michalstocki/tiny-timer/docs/obudowa-klin-4/renders/16-przekroj-przycisk-plus.png

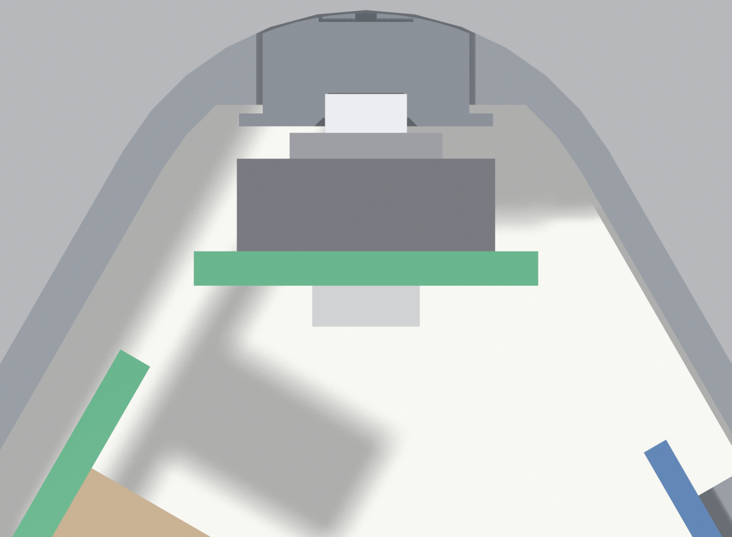
docs/obudowa-klin-4/renders/16-przekroj-przycisk-plus.png
