michalstocki/tiny-timer/docs/obudowa-klin-4/renders/10-ogniwa-od-gory.png

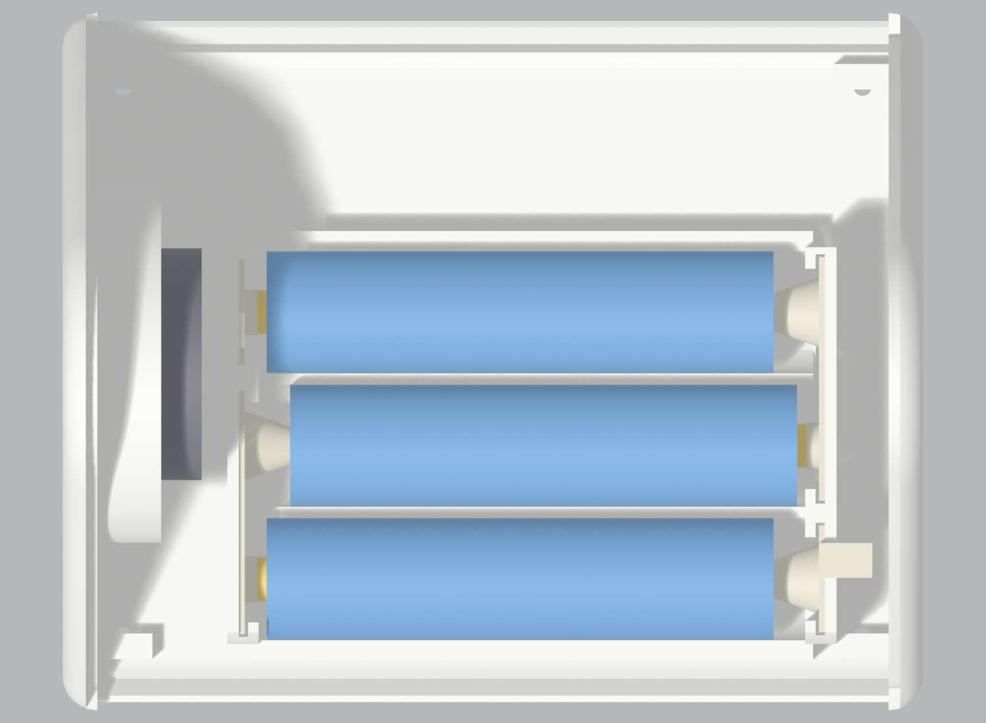
docs/obudowa-klin-4/renders/10-ogniwa-od-gory.png
