michalstocki/tiny-timer/docs/obudowa-klin-4/renders/01-przod-iso.png

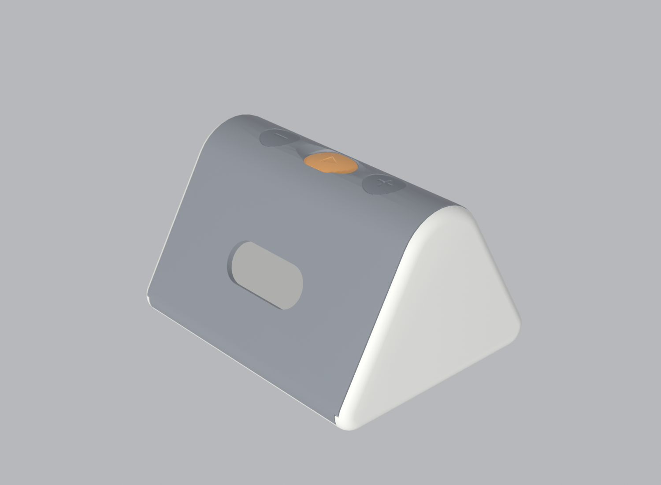
docs/obudowa-klin-4/renders/01-przod-iso.png
