michalstocki/tiny-timer/docs/obudowa-klin-4/renders/02-przod-prostopadle.png

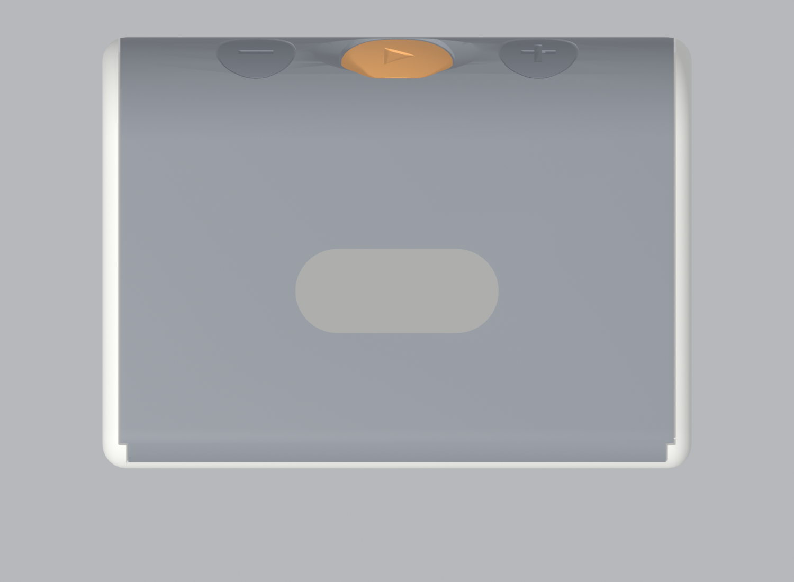
docs/obudowa-klin-4/renders/02-przod-prostopadle.png
