michalstocki/tiny-timer/docs/obudowa-klin-4/renders/03-gora.png

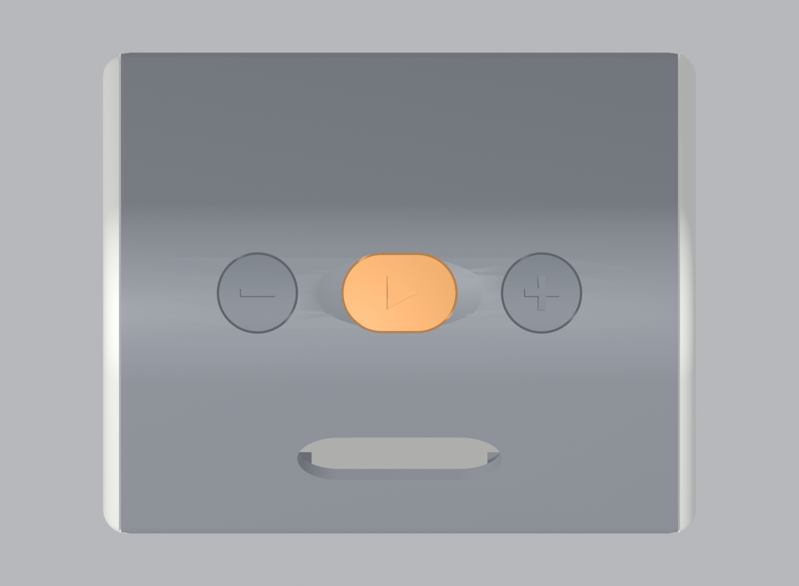
docs/obudowa-klin-4/renders/03-gora.png
