michalstocki/tiny-timer/docs/obudowa-klin-4/renders/04-bok-lewy-glosnik.png

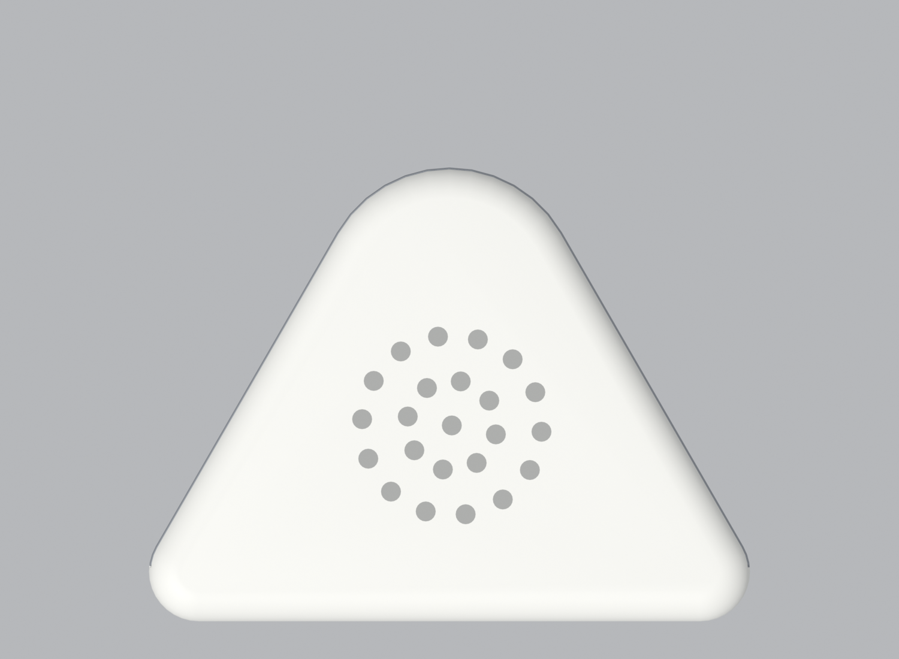
docs/obudowa-klin-4/renders/04-bok-lewy-glosnik.png
