michalstocki/tiny-timer/docs/obudowa-klin-4/renders/05-bok-prawy.png

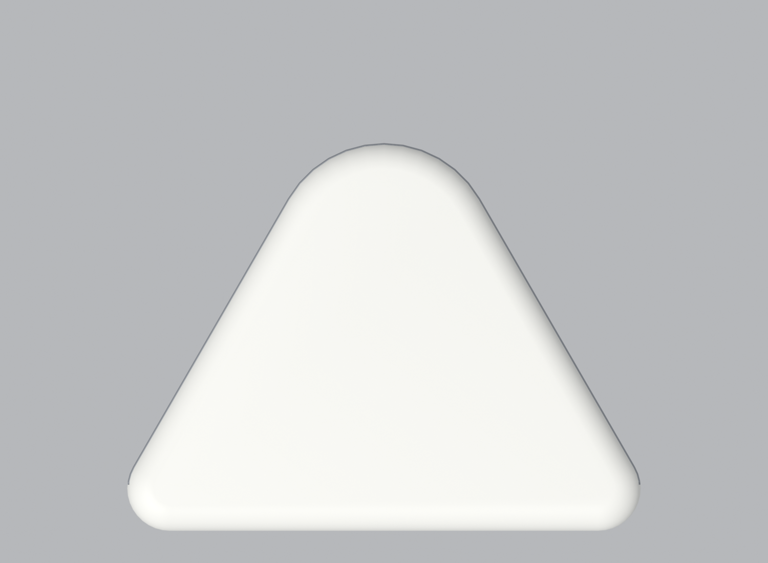
docs/obudowa-klin-4/renders/05-bok-prawy.png
