michalstocki/tiny-timer/docs/obudowa-klin-4/renders/06-spod.png

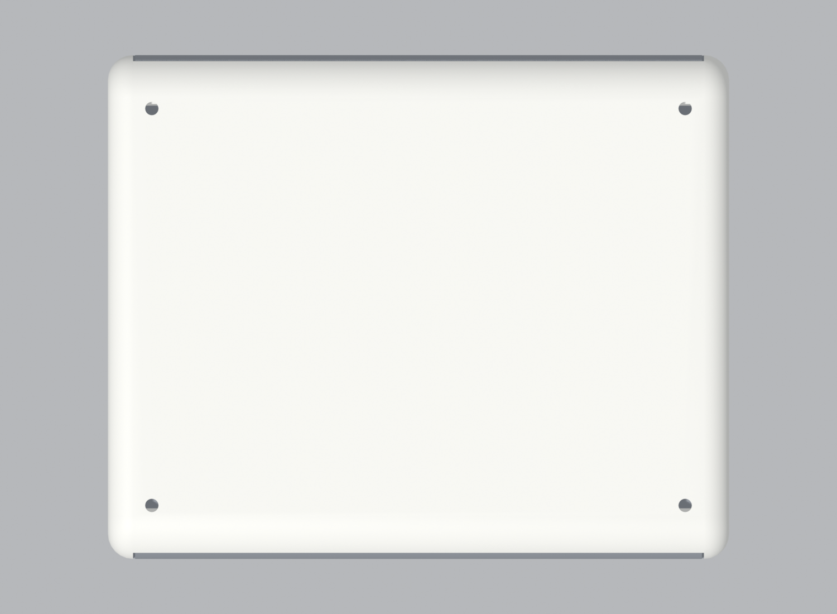
docs/obudowa-klin-4/renders/06-spod.png
