michalstocki/tiny-timer/docs/obudowa-klin-4/renders/07-tyl-iso.png

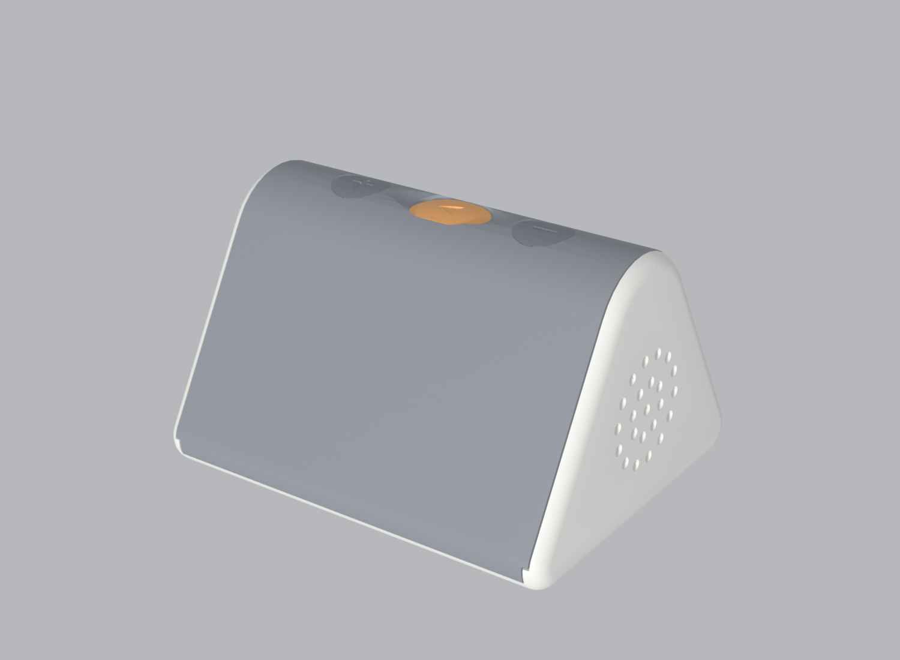
docs/obudowa-klin-4/renders/07-tyl-iso.png
