michalstocki/tiny-timer/docs/obudowa-klin-4/renders/08-tyl-prostopadle.png

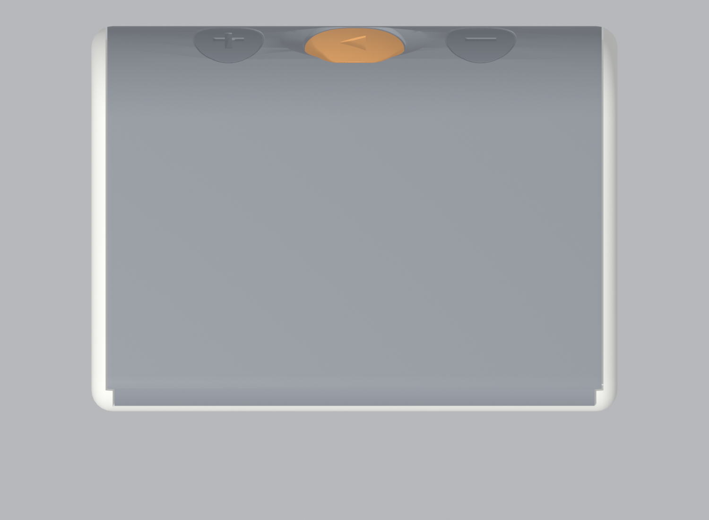
docs/obudowa-klin-4/renders/08-tyl-prostopadle.png
