michalstocki/tiny-timer/docs/obudowa-klin-4/renders/09-pokrywa-zdjeta.png

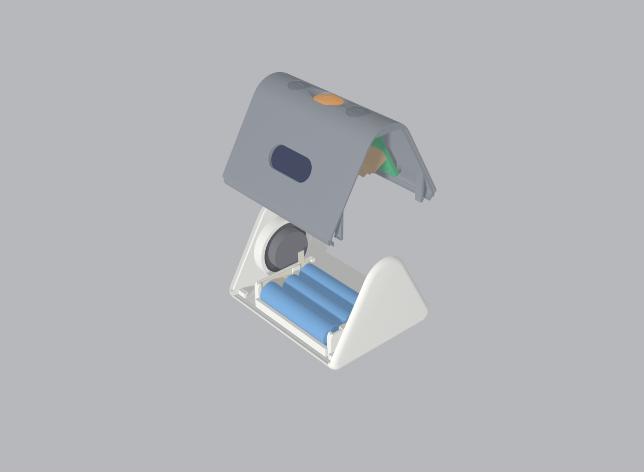
docs/obudowa-klin-4/renders/09-pokrywa-zdjeta.png
