michalstocki/tiny-timer/docs/obudowa-klin-4/renders/11-koszyk-styki.png

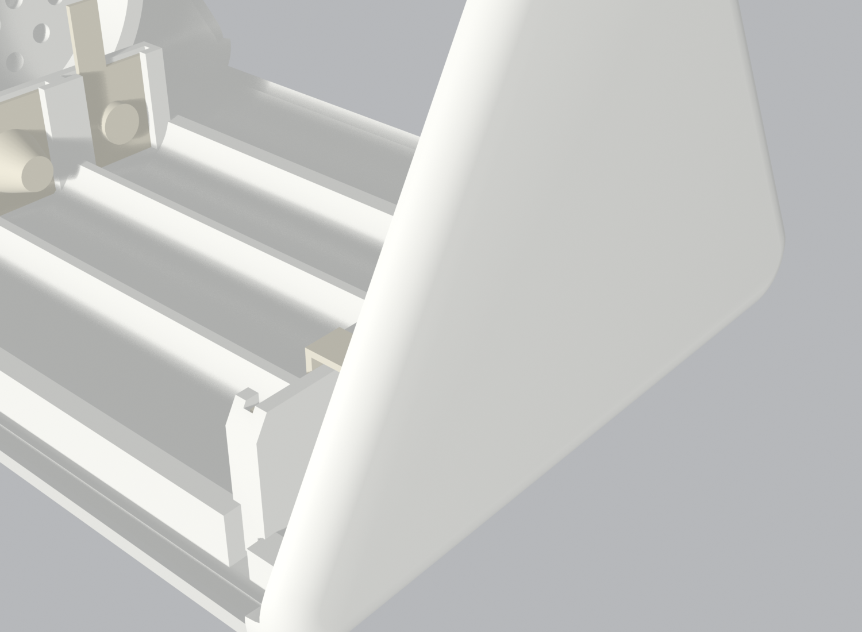
docs/obudowa-klin-4/renders/11-koszyk-styki.png
