michalstocki/tiny-timer/docs/obudowa-klin-4/renders/12-pokrywa-od-srodka.png

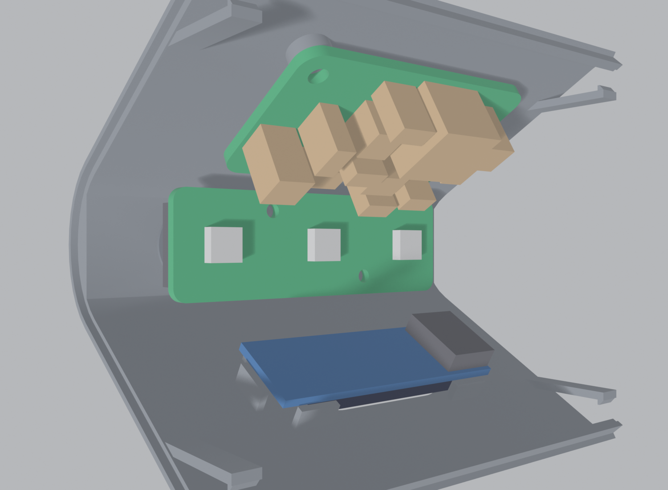
docs/obudowa-klin-4/renders/12-pokrywa-od-srodka.png
