michalstocki/tiny-timer/docs/obudowa-klin-4/renders/13-przekroj-poprzeczny.png

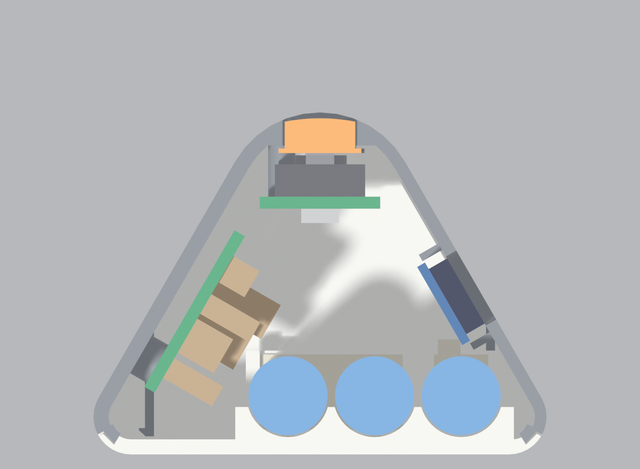
docs/obudowa-klin-4/renders/13-przekroj-poprzeczny.png
