michalstocki/tiny-timer/docs/obudowa-klin-4/renders/14-przekroj-zatrzaski.png

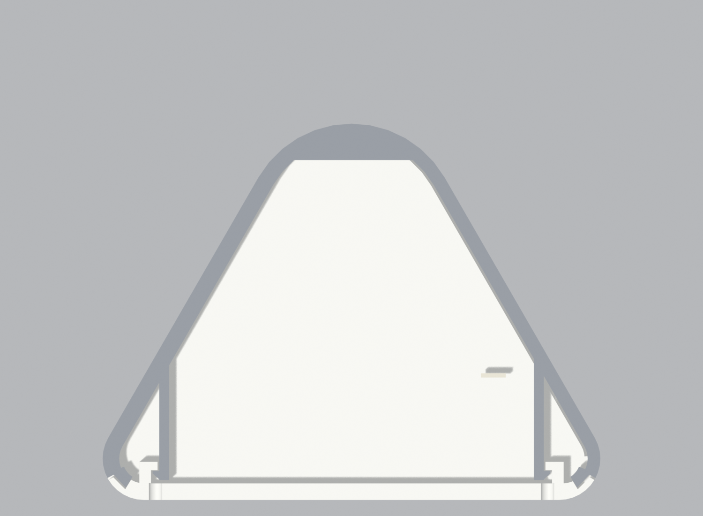
docs/obudowa-klin-4/renders/14-przekroj-zatrzaski.png
