michalstocki/tiny-timer/docs/obudowa-klin-4/renders/15-zatrzask-front-zblizenie.png

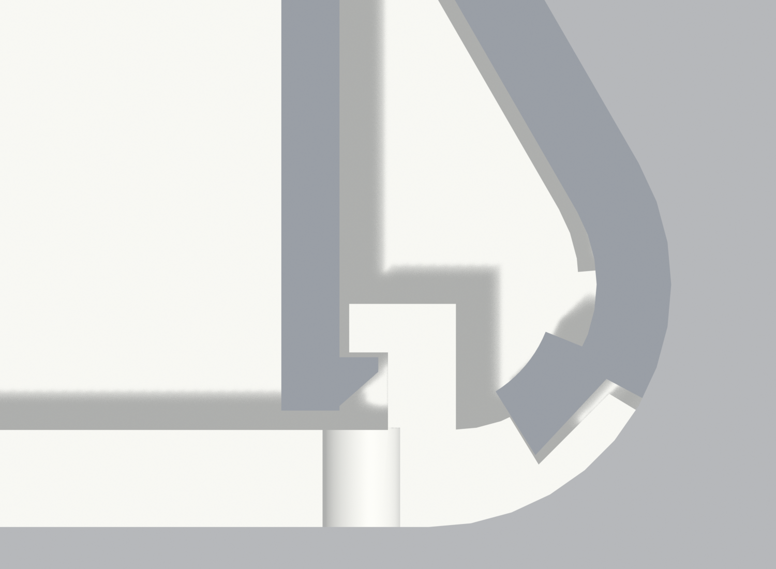
docs/obudowa-klin-4/renders/15-zatrzask-front-zblizenie.png
