michalstocki/tiny-timer/docs/obudowa-klin-4/renders/17-przyciski-zblizenie.png

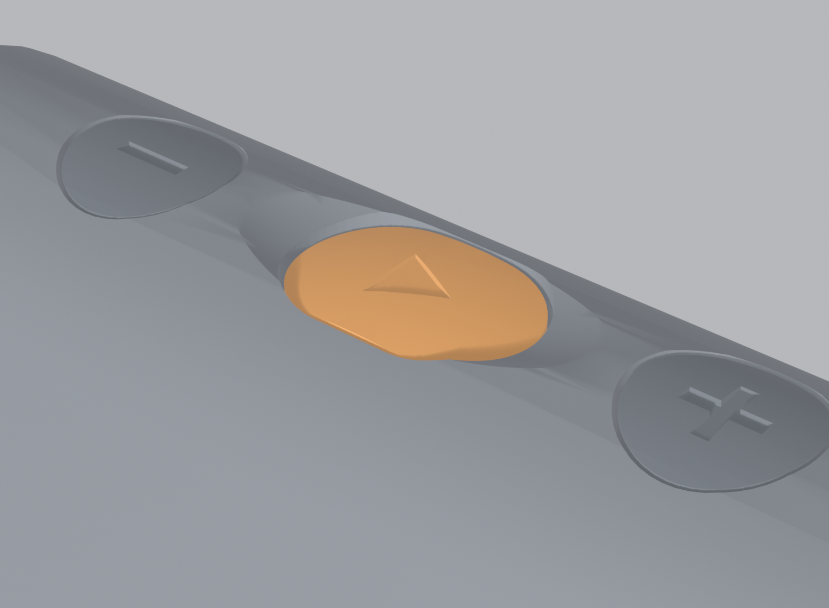
docs/obudowa-klin-4/renders/17-przyciski-zblizenie.png
