michalstocki/tiny-timer/docs/obudowa-klin-4/renders/18-kapsel-gniazdo.png

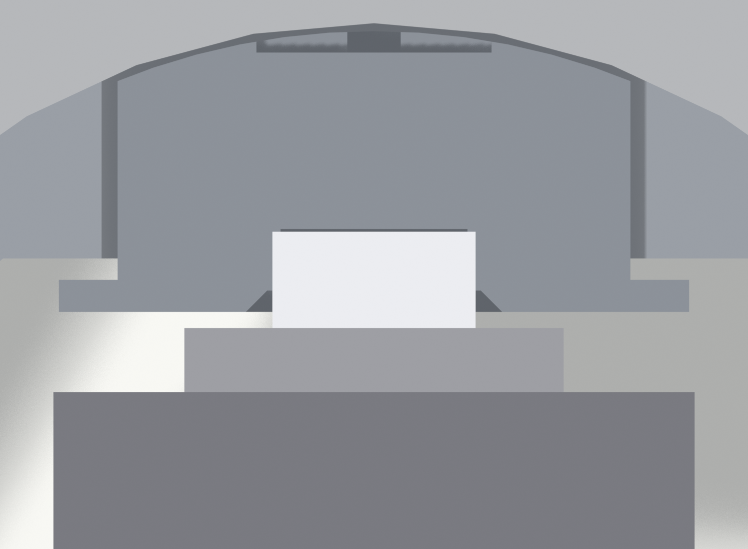
docs/obudowa-klin-4/renders/18-kapsel-gniazdo.png
