michalstocki/tiny-timer/docs/obudowa-klin-4/renders/19-przekroj-gniazda-styku.png

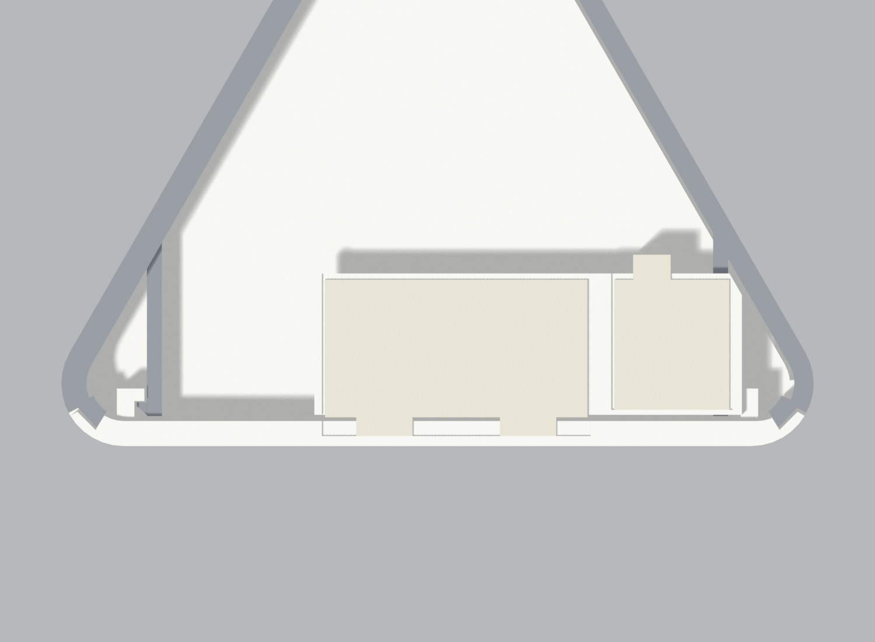
docs/obudowa-klin-4/renders/19-przekroj-gniazda-styku.png
