michalstocki/tiny-timer/docs/obudowa-klin-4/renders/20-szew-tylu-zblizenie.png

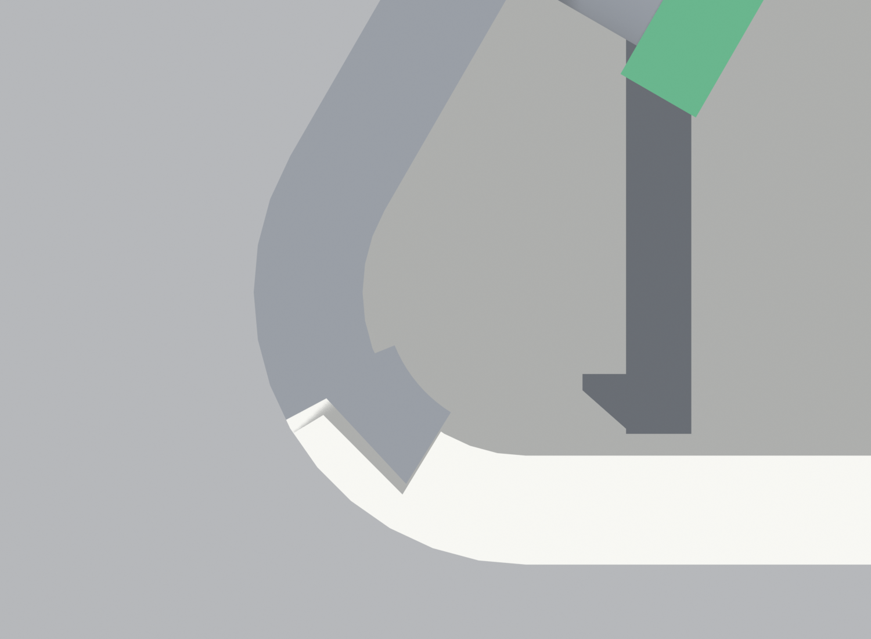
docs/obudowa-klin-4/renders/20-szew-tylu-zblizenie.png
