michalstocki/tiny-timer/docs/obudowa-klin-4/pokrywa.stl

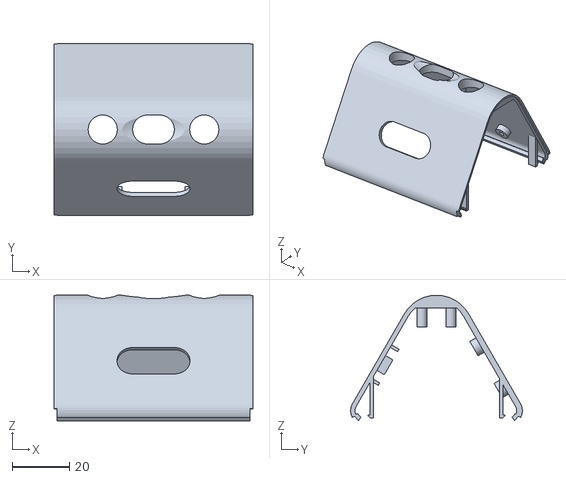
[picture p23: CAD file, 2026-10-22]
docs/obudowa-klin-4/pokrywa.stl
69.7 x 60.2 x 44.0
