michalstocki/tiny-timer/docs/obudowa-klin-4/korpus.stl

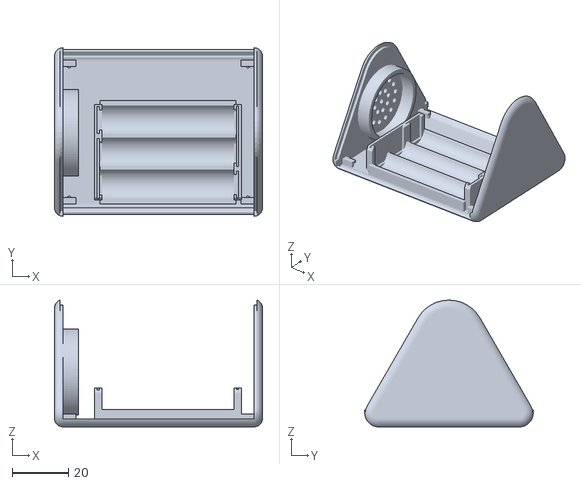
[picture p24: CAD file, 2026-10-22]
docs/obudowa-klin-4/korpus.stl
74.2 x 60.2 x 45.3
