michalstocki/tiny-timer/docs/obudowa-klin-4/kapsle.stl

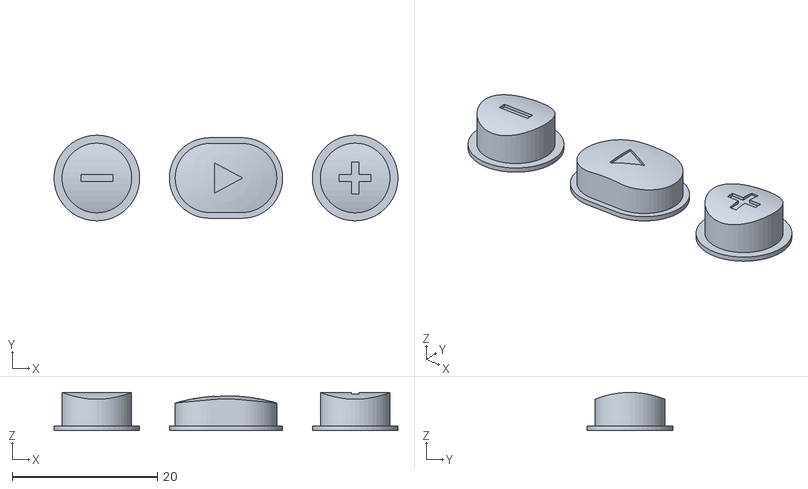
[picture p25: CAD file, 2026-10-22]
docs/obudowa-klin-4/kapsle.stl
47.4 x 11.8 x 5.25
