michalstocki/tiny-timer/(list of files, cad)

Other CAD files:
docs/obudowa-klin-4/obudowa-klin-4-bez-zaczepow.blend
docs/obudowa-klin-4/obudowa-klin-4.blend
