michalstocki/tiny-timer/(list of files, drawings)

Other design files:
docs/pcb-klin3/pcb-layout.json
