michalstocki/tiny-timer/docs/plytka-glowna/tt-main.kicad_pcb

## KiCad design docs/plytka-glowna/tt-main.kicad_pcb (2026-10-22)

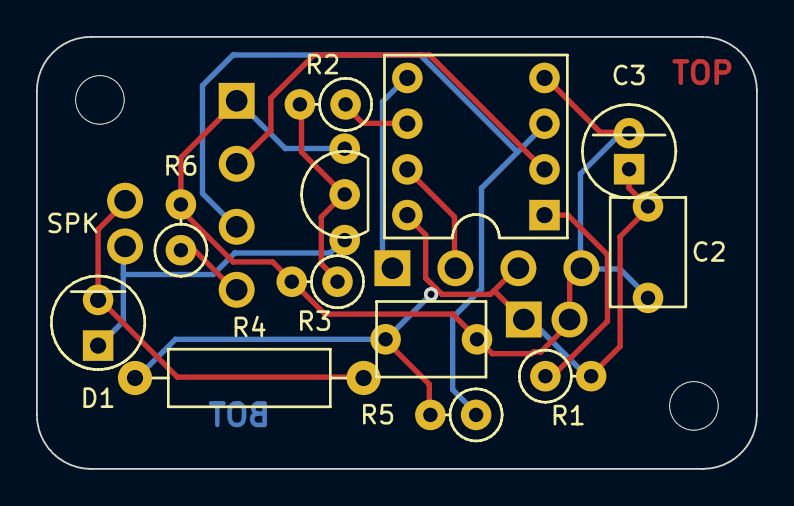
[picture p26: board tt-main.kicad_pcb from above]

Board: 2 copper layers, 40.0 x 24.0 mm, 18 parts (0 on the bottom side), 12 nets.

Parts:
BAT: battery leads; wire2
C1, C2: 100 nF; cap5
C3: 100 uF; elco5
D1: LED; led
DISP: display module leads; wire4
KEY: button board leads; wire4
MH1, MH2: M2.5; MountingHole_M2.5
Q1: BC547B; to92
R1: 15 k; res_v
R2: 470; res_v
R3: 47 k; res_v
R4: 33, 1/2 W; res_h
R5, R6: 8.2 k; res_v
SPK: speaker leads; wire2
U1: ATtiny13A in DIP-8 socket; dip8

Connections:
BASE: Q1.B, R2.2, R3.1
COLL: D1.A, Q1.C, SPK.2
GND: BAT.2, C1.1, C2.1, C3.-, DISP.4, KEY.1, Q1.E, R3.2, R6.2, U1.4
PB1: R2.1, U1.6
PB3: KEY.2, U1.2
PB4: KEY.3, R5.1, U1.3
RESET: R1.1, U1.1
S3LOW: KEY.4, R6.1
SCL: DISP.2, U1.7
SDA: DISP.1, U1.5
SPKR: D1.K, R4.1, SPK.1
VCC: BAT.1, C1.2, C2.2, C3.+, DISP.3, R1.2, R4.2, R5.2, U1.8
