michalstocki/tiny-timer/firmware/src/render.c

/* Frame renderer: "M:SS" (5x7 font scaled x3), 1 px progress frame, bell.
 * Pure computation, no hardware access: also built on the host
 * (tools/host_render.c) to check the picture without a display.
 *
 * The OLED is in VERTICAL addressing mode, so the stream is column by
 * column: 4 bytes (pages 0..3 = rows 0..31, bit0 = top) for x = 0..127. */
#include "oled.h"

#ifdef __AVR__
#include <avr/pgmspace.h>
#else
#define PROGMEM
#define pgm_read_byte(a) (*(const uint8_t *)(a))
#define pgm_read_word(a) (*(const uint16_t *)(a))
#endif

#define BELL_X 106 /* left column of the 16x16 bell, rows 8..23 */

NOINIT uint8_t txt[5];
#if FEATURE_BAR
NOINIT uint16_t bar_lit;
#endif
#if FEATURE_BELL
NOINIT uint8_t bell;
#endif

/* 5x7 font, glyph = 5 columns, bit0 = top row. 0-9 and ':'. */
static const uint8_t font[11 * 5] PROGMEM = {
    0x3E, 0x51, 0x49, 0x45, 0x3E, /* 0 */
    0x00, 0x42, 0x7F, 0x40, 0x00, /* 1 */
    0x42, 0x61, 0x51, 0x49, 0x46, /* 2 */
    0x21, 0x41, 0x45, 0x4B, 0x31, /* 3 */
    0x18, 0x14, 0x12, 0x7F, 0x10, /* 4 */
    0x27, 0x45, 0x45, 0x45, 0x39, /* 5 */
    0x3C, 0x4A, 0x49, 0x49, 0x30, /* 6 */
    0x01, 0x71, 0x09, 0x05, 0x03, /* 7 */
    0x36, 0x49, 0x49, 0x49, 0x36, /* 8 */
    0x06, 0x49, 0x49, 0x29, 0x1E, /* 9 */
    0x00, 0x00, 0x14, 0x00, 0x00, /* : */
};

#if FEATURE_BELL
/* 16x16 bell, one word per column (generated by tools/gen_bell.py). */
static const uint16_t bell_bmp[16] PROGMEM = {
    0x2000, 0x3800, 0x3E00, 0x3FC0, 0x3FF8, 0x7FFC, 0xFFFE, 0xFFFF,
    0xFFFF, 0xFFFE, 0x7FFC, 0x3FF8, 0x3FC0, 0x3E00, 0x3800, 0x2000,
};
#endif

NOINIT static uint8_t x; /* column being produced */

/* Emit one screen column. f = 7 font rows (bit0 = top). Every font row
 * becomes 3 screen rows: font row k -> rows 5+3k .. 7+3k (text is 21 px
 * tall in rows 5..25). */
static void col(uint8_t f)
{
    uint32_t v = 0;
    uint32_t m = 7UL << 5;

    for (uint8_t i = 7; i; i--) {
        if (f & 1)
            v |= m;
        f >>= 1;
        m <<= 3;
    }
#if FEATURE_BELL
    if (bell && (uint8_t)(x - BELL_X) < 16)
        v |= (uint32_t)pgm_read_word(&bell_bmp[x - BELL_X]) << 8;
#endif
#if FEATURE_BAR
    /* Frame pixels are numbered clockwise from the top-left corner:
     *   top row y=0:      idx = x                  (0..127)
     *   right col x=127:  idx = 127 + y            (y 1..31)
     *   bottom row y=31:  idx = 285 - x            (x 126..0)
     *   left col x=0:     idx = 316 - y            (y 30..1)
     * A pixel is lit when idx >= 316 - bar_lit, so the frame is erased
     * clockwise starting at the top-left corner. */
    int16_t start = BAR_PIXELS - bar_lit;
    if (x >= start)
        v |= 1UL;
    if (285 - x >= start)
        v |= 1UL << 31;
    if (x == 127 || x == 0) {
        for (uint8_t y = 1; y < 31; y++)
            if ((x ? 127 + y : 316 - y) >= start)
                v |= 1UL << y;
    }
#endif
    oled_put(v);
    oled_put(v >> 8);
    oled_put(v >> 16);
    oled_put(v >> 24);
    x++;
}

/* txt[] = {m10, m1, ':', s10, s1}; a zero in txt[0] is not drawn and the
 * remaining 4 cells (18 px each) are centered. */
void render_frame(void)
{
    uint8_t ci = !txt[0];            /* first cell drawn                   */

    x = 0;
    while (x < (ci ? 28 : 19))
        col(0);
    for (; ci < 5; ci++) {
        for (uint8_t fc = 0; fc < 6; fc++) {
            uint8_t f = 0, g = txt[ci]; /* 6th column is the gap           */
            if (fc < 5)
                f = pgm_read_byte(&font[(g << 2) + g + fc]);
            col(f);
            col(f);
            col(f);
        }
    }
    while (x < 128)
        col(0);
}
