michalstocki/tiny-timer/tools/pcb/export.py

#!/usr/bin/env python3
"""Exports for the enclosure agent: pcb-layout.json, pcb_params.scad,
side-view SVG and an interactive 3D preview (podglad-3d.html)."""
import json
import math
import os

import board as B


def layout_json():
    d = B.to_json()
    d["derived"] = dict(
        board_center=[B.D["cx"], B.D["cy"]],
        oled_module=dict(rect=B.body_rect("OLED"), pcb_thickness_assumed=1.2,
                         total_thickness_above_board=B.P["oled_thickness"] + B.P["oled_standoff"],
                         glass_rect=[B.D["oled_pin_x"] + B.P["glass_to_pin"],
                                     B.D["oled_cy"] - B.P["glass_h"] / 2,
                                     B.D["oled_pin_x"] + B.P["glass_to_pin"] + B.P["glass_w"],
                                     B.D["oled_cy"] + B.P["glass_h"] / 2]),
        buttons={ref: dict(centre=[B.PARTS[ref]["x"], B.PARTS[ref]["y"]], body=12.0,
                           plunger_square=B.P["btn_plunger"], cap_diameter=B.P["btn_cap_d"],
                           top_above_board=B.P["btn_height"],
                           label={"S3": "minus", "S1": "run", "S2": "plus"}[ref])
                 for ref in ("S3", "S1", "S2") if ref in B.PARTS},
        back_envelope_height=B.P["bottom_height"],
        front_free_zone_above_board="everything on the front except the OLED module and the buttons must stay below 2.0 mm (solder joints of the back parts)")
    if B.VARIANT == "klin":
        d["variant"] = "klin"
        d["derived"]["front_free_zone_above_board"] = "everything on the front except the OLED module must stay below 2.0 mm (solder joints of the back parts)"
        d["button_board"] = dict(
            note="separate board with the 3 buttons, wired to the KEY pads of the main board",
            width=52.0, depth=16.0, thickness=B.P["thickness"], corner_radius=2.0,
            buttons=[dict(label="minus", ref="S3", x=8.0, y=8.0), dict(label="run", ref="S1", x=26.0, y=8.0),
                     dict(label="plus", ref="S2", x=44.0, y=8.0)],
            mounting_holes=[dict(x=16.0, y=8.0, diameter=2.2), dict(x=36.0, y=8.0, diameter=2.2)],
            wires=dict(KEY1="GND (S1, S2 common)", KEY2="PB3 (S1 run)", KEY3="PB4 (S2 plus, S3 minus)",
                       KEY4="S3 low side (to R6 on the main board)"))
    return d


def layout_json_k3():
    """klin3: the main board carries only the electronics; display module and button board are separate (wired)."""
    d = B.to_json()
    d["variant"] = "klin3"
    d["derived"] = dict(
        board_center=[B.D["cx"], B.D["cy"]], back_envelope_height=B.P["bottom_height"],
        note="the board is mounted component side INWARDS on the rear wall of the enclosure; the TOP side (solder joints, "
             "trimmed leads up to 2.0 mm) faces the wall")
    d["display_module"] = dict(
        note="SSD1306 128x32 0.91\" module glued to the inside of the front panel, wired to the pads DISP 1..4",
        outline=[B.P["oled_len"], B.P["oled_h"]], thickness=B.P["oled_thickness"], glass=[B.P["glass_w"], B.P["glass_h"]],
        pin_to_end=B.P["oled_pin_to_edge"], glass_to_pin=B.P["glass_to_pin"], header_standoff=B.P["oled_standoff"],
        pins=["SDA", "SCL", "VCC", "GND"], wires=dict(DISP1="SDA", DISP2="SCL", DISP3="VCC", DISP4="GND"))
    # buttons 7 grid steps apart (17.78 mm) so the board can be a 2.54 mm perfboard; B3F legs (12.5 x 5.0) sit in a
    # 5 x 2 grid rectangle, so button centres are at half a grid step in x and the M2 holes midway between them land on
    # grid points; the holes are 2 grid steps off the button row (diagonally), so the enclosure posts clear the run cap flange
    pitch, g = 7 * 2.54, 2.54
    d["button_board"] = dict(
        note="separate board with the 3 buttons, wired to the KEY pads of the main board; fits a 2.54 mm perfboard",
        width=50.0, depth=16.0, thickness=B.P["thickness"], corner_radius=2.0, grid=2.54,
        buttons=[dict(label="minus", ref="S3", x=round(25.0 - pitch, 2), y=8.0), dict(label="run", ref="S1", x=25.0, y=8.0),
                 dict(label="plus", ref="S2", x=round(25.0 + pitch, 2), y=8.0)],
        mounting_holes=[dict(x=round(25.0 - pitch / 2, 2), y=round(8.0 - 2 * g, 2), diameter=2.2),
                        dict(x=round(25.0 + pitch / 2, 2), y=round(8.0 + 2 * g, 2), diameter=2.2)],
        wires=dict(KEY1="GND (S1, S2 common)", KEY2="PB3 (S1 run)", KEY3="PB4 (S2 plus, S3 minus)",
                   KEY4="S3 low side (to R6 on the main board)"))
    return d


def scad_params(d):
    L = ["// Generated by tools/pcb (iteration 1). Millimetres, front view, origin = lower-left of the board.",
         "board_w = %.2f; board_h = %.2f; board_t = %.2f; board_corner_r = %.2f;" % (
             d["board"]["width"], d["board"]["height"], d["board"]["thickness"], d["board"]["corner_radius"]),
         "mount_holes = [%s]; // [x, y]" % ", ".join("[%.2f, %.2f]" % (h["x"], h["y"]) for h in d["mounting_holes"]),
         "mount_hole_d = %.2f; mount_keepout_r = %.2f;" % (B.P["mount_d"], B.P["mount_keepout_r"])]
    o = d["derived"]["oled_module"]
    g = o["glass_rect"]
    L += ["oled_module = [%.2f, %.2f, %.2f, %.2f]; // x0, y0, x1, y1 (ESTIMATED module outline)" % tuple(o["rect"]),
          "oled_glass = [%.2f, %.2f, %.2f, %.2f];" % tuple(g),
          "oled_total_height = %.2f; // above the board's top surface (assumes 2.5 mm header standoff)" % o["total_thickness_above_board"]]
    for ref, b in d["derived"]["buttons"].items():
        L.append("button_%s = [%.2f, %.2f]; // centre; body 12x12, plunger 3.8 sq, cap d 7.1, top at %.1f mm" % (
            b["label"], b["centre"][0], b["centre"][1], b["top_above_board"]))
    if B.VARIANT == "base":
        L.append("button_top_height = %.2f; button_body = 12; button_plunger = 3.8; button_cap_d = 7.1;" % B.P["btn_height"])
    else:
        L.append("// buttons are on a separate board (48 x 16 mm), see pcb-layout.json: button_board")
    L.append("back_envelope_height = %.2f;" % B.P["bottom_height"])
    L.append("// back-side parts: [name, x0, y0, x1, y1, height]")
    items = []
    for ref, p in d["parts"].items():
        if p["side"] == "bottom" and p["body"]:
            b = p["body"]
            items.append('["%s", %.2f, %.2f, %.2f, %.2f, %.2f]' % (ref, b[0], b[1], b[2], b[3], p["height_above_board"]))
    L.append("back_parts = [\n  " + ",\n  ".join(items) + "\n];")
    return "\n".join(L) + "\n"


def side_svg():
    """Side elevation (looking along +x ... shows heights stack at the section through the middle button)."""
    S = 20.0
    M = 40
    W, H = B.P["W"], B.P["H"]
    t = B.P["thickness"]
    top_h = max(B.P["btn_height"] if B.VARIANT == "base" else 0.0, B.P["oled_thickness"] + B.P["oled_standoff"])
    bot_h = B.P["bottom_height"]
    wpx = int(W * S + 2 * M)
    hpx = int((top_h + t + bot_h) * S + 2 * M + 60)
    y0 = M + top_h * S               # top surface of the board
    p = ['<svg xmlns="http://www.w3.org/2000/svg" viewBox="0 0 %d %d" width="%d" height="%d" font-family="Helvetica, Arial, sans-serif">' % (wpx, hpx, wpx, hpx),
         '<rect width="100%" height="100%" fill="#fff"/>',
         '<text x="%d" y="22" font-size="12" font-weight="bold">Rzut z boku: wysokości elementów (wszystkie elementy rzutowane na płaszczyznę x–z; x w prawo)</text>' % M]

    def rect(x0, z0, x1, z1, fill, label=None, stroke="#222"):
        # z measured up from the top surface of the board (negative = back side)
        p.append('<rect x="%.1f" y="%.1f" width="%.1f" height="%.1f" fill="%s" stroke="%s" stroke-width="1"/>' % (
            M + x0 * S, y0 - z1 * S, (x1 - x0) * S, (z1 - z0) * S, fill, stroke))
        if label:
            p.append('<text x="%.1f" y="%.1f" font-size="9" text-anchor="middle" fill="#111">%s</text>' % (
                M + (x0 + x1) / 2 * S, y0 - (z0 + z1) / 2 * S + 3, label))
    rect(0, -t, W, 0, "#2f6b3a")
    # OLED module: PCB 1.2 + glass, standing on a 2.5 mm header
    o = B.body_rect("OLED")
    so = B.P["oled_standoff"]
    rect(o[0], so, o[2], so + 1.2, "#16335f", "OLED")
    gx0 = B.D["oled_pin_x"] + B.P["glass_to_pin"]
    rect(gx0, so + 1.2, gx0 + B.P["glass_w"], so + B.P["oled_thickness"], "#05070b")
    rect(B.D["oled_pin_x"] - 1.3, 0, B.D["oled_pin_x"] + 1.3, so, "#555")
    for ref in [r for r in ("S3", "S1", "S2") if r in B.PARTS]:
        q = B.PARTS[ref]
        rect(q["x"] - 6, 0, q["x"] + 6, 4.3, "#3a3a40", ref)
        rect(q["x"] - B.P["btn_cap_d"] / 2, 4.3, q["x"] + B.P["btn_cap_d"] / 2, 5.5, "#202024")
        rect(q["x"] - 1.9, 5.5, q["x"] + 1.9, B.P["btn_height"], "#555")
    for ref in B.REFS_BOTTOM:
        pr = B.PARTS[ref]
        b = B.body_rect(ref)
        if b is None:
            continue
        h = B.FP[pr["fp"]]["height"]
        if ref == "U1":
            rect(b[0], -t - 4.5, b[2], -t, "#2b2b30", "gniazdo")
            rect(b[0] + 1.2, -t - 8.5, b[2] - 1.2, -t - 4.5, "#111", "ATtiny")
        else:
            rect(b[0], -t - h, b[2], -t, "#e8d3a6", ref)
    # dimension: envelope
    p.append('<line x1="%d" y1="%.1f" x2="%d" y2="%.1f" stroke="#b00" stroke-dasharray="4 3"/>' % (M, y0 + (t + bot_h) * S, M + W * S, y0 + (t + bot_h) * S))
    p.append('<text x="%d" y="%.1f" font-size="10" fill="#b00">obwiednia tyłu: %.1f mm pod płytką</text>' % (M + 4, y0 + (t + bot_h) * S + 12, bot_h))
    if B.VARIANT == "base":
        p.append('<line x1="%d" y1="%.1f" x2="%d" y2="%.1f" stroke="#080" stroke-dasharray="4 3"/>' % (M, y0 - B.P["btn_height"] * S, M + W * S, y0 - B.P["btn_height"] * S))
        p.append('<text x="%d" y="%.1f" font-size="10" fill="#080">góra trzpienia przycisku: %.1f mm nad płytką</text>' % (M + 4, y0 - B.P["btn_height"] * S - 4, B.P["btn_height"]))
    p.append("</svg>")
    return "\n".join(p)


HTML = """<!doctype html>
<html lang="pl"><head><meta charset="utf-8"><meta name="viewport" content="width=device-width,initial-scale=1">
<title>Podgląd 3D płytki: minutnik ATtiny13A</title>
<style>
body{margin:0;font-family:Helvetica,Arial,sans-serif;background:#f4f4f2;color:#222}
#bar{position:fixed;top:8px;left:8px;background:#fffd;padding:8px 10px;border-radius:8px;font-size:13px;z-index:2}
#bar button{margin:2px;padding:4px 8px;cursor:pointer}
canvas{display:block}
#note{position:fixed;bottom:8px;left:8px;font-size:12px;color:#555;background:#fffc;padding:6px 8px;border-radius:6px}
</style></head><body>
<div id="bar"><b>Płytka %(W).0f × %(H).0f mm</b> &nbsp;
<button onclick="view('front')">przód</button><button onclick="view('back')">tył</button>
<button onclick="view('side')">bok</button><button onclick="view('iso')">ukośnie</button>
<label><input type="checkbox" id="expl" onchange="explode()"> rozsunięcie</label></div>
<div id="note">Przeciągnij myszą, aby obracać; kółko: zoom. Wymiary w mm. Przód (góra) = wyświetlacz i przyciski; tył = reszta. Wymiary oznaczone w specyfikacji jako „szacunkowe” to estymaty.</div>
<script src="https://cdnjs.cloudflare.com/ajax/libs/three.js/r128/three.min.js"></script>
<script>
const DATA = %(DATA)s;
const W = DATA.board.width, H = DATA.board.height, T = DATA.board.thickness;
const scene = new THREE.Scene(); scene.background = new THREE.Color(0xf4f4f2);
const cam = new THREE.PerspectiveCamera(35, innerWidth/innerHeight, 1, 1000);
const ren = new THREE.WebGLRenderer({antialias:true}); ren.setSize(innerWidth, innerHeight); document.body.appendChild(ren.domElement);
scene.add(new THREE.AmbientLight(0xffffff, 0.65));
const dl = new THREE.DirectionalLight(0xffffff, 0.7); dl.position.set(-60, -80, 120); scene.add(dl);
const dl2 = new THREE.DirectionalLight(0xffffff, 0.35); dl2.position.set(80, 60, -90); scene.add(dl2);
// board frame: x right, y up, z towards the viewer of the FRONT side; board top surface at z = 0
const root = new THREE.Group(); scene.add(root);
function box(x0,y0,x1,y1,z0,z1,color,grp){
  const m = new THREE.Mesh(new THREE.BoxGeometry(x1-x0,y1-y0,z1-z0), new THREE.MeshLambertMaterial({color}));
  m.position.set((x0+x1)/2-W/2,(y0+y1)/2-H/2,(z0+z1)/2); (grp||root).add(m); return m; }
function cyl(x,y,r,z0,z1,color,grp){
  const g = new THREE.CylinderGeometry(r,r,z1-z0,24); g.rotateX(Math.PI/2);
  const m = new THREE.Mesh(g,new THREE.MeshLambertMaterial({color})); m.position.set(x-W/2,y-H/2,(z0+z1)/2); (grp||root).add(m); return m; }
const front = new THREE.Group(), back = new THREE.Group(); root.add(front); root.add(back);
box(0,0,W,H,-T,0,0x2f6b3a);
DATA.mounting_holes.forEach(h=>{ const c=cyl(h.x,h.y,h.diameter/2,-T-0.05,0.05,0xf4f4f2); });
const o = DATA.derived.oled_module, g = o.glass_rect, so = 2.5;
box(o.rect[0],o.rect[1],o.rect[2],o.rect[3],so,so+1.2,0x16335f,front);
box(g[0],g[1],g[2],g[3],so+1.2,o.total_thickness_above_board,0x05070b,front);
box(DATA.parts.OLED.pads.SDA.x-1.3,DATA.parts.OLED.pads.GND.y-0.0,DATA.parts.OLED.pads.SDA.x+1.3,DATA.parts.OLED.pads.SDA.y,0,so,0x333333,front);
['S3','S1','S2'].forEach(r=>{ const b=DATA.derived.buttons[r], c=b.centre;
  box(c[0]-6,c[1]-6,c[0]+6,c[1]+6,0,4.3,0x3a3a40,front);
  cyl(c[0],c[1],b.cap_diameter/2,4.3,5.5,0x202024,front);
  box(c[0]-1.9,c[1]-1.9,c[0]+1.9,c[1]+1.9,5.5,b.top_above_board,0x666666,front); });
for (const [ref,p] of Object.entries(DATA.parts)) {
  if (p.side!=='bottom'||!p.body) continue; const b=p.body, h=p.height_above_board;
  if (ref==='U1'){ box(b[0],b[1],b[2],b[3],-T-4.5,-T,0x2b2b30,back); box(b[0]+1.2,b[1]+1.2,b[2]-1.2,b[3]-1.2,-T-8.5,-T-4.5,0x111111,back); }
  else if (ref==='C3'){ cyl((b[0]+b[2])/2,(b[1]+b[3])/2,2.5,-T-h,-T,0x243b6b,back); }
  else { const col = ref==='D1'?0xff8a8a:(ref==='Q1'?0x222222:0xe8d3a6); box(b[0],b[1],b[2],b[3],-T-h,-T,col,back); }
}
let theta=0.0, phi=0.0, dist=140, tgt=new THREE.Vector3(0,0,0), curView='iso';
function setCam(){ cam.up.set(0,1,0);
  const x=dist*Math.sin(theta)*Math.cos(phi), y=dist*Math.sin(phi), z=dist*Math.cos(theta)*Math.cos(phi);
  cam.position.set(tgt.x+x,tgt.y+y,tgt.z+z); cam.lookAt(tgt); }
function view(v){ curView=v; if(v==='front'){theta=0;phi=0;} if(v==='back'){theta=Math.PI;phi=0;} if(v==='side'){theta=Math.PI/2;phi=0;} if(v==='iso'){theta=0.6;phi=0.5;} setCam(); }
function explode(){ const e=document.getElementById('expl').checked; front.position.z=e?14:0; back.position.z=e?-14:0; }
let drag=null; ren.domElement.addEventListener('mousedown',e=>{drag=[e.clientX,e.clientY];});
addEventListener('mouseup',()=>drag=null);
addEventListener('mousemove',e=>{ if(!drag) return; theta-=(e.clientX-drag[0])*0.008; phi+=(e.clientY-drag[1])*0.008; phi=Math.max(-1.5,Math.min(1.5,phi)); drag=[e.clientX,e.clientY]; setCam(); });
addEventListener('wheel',e=>{ dist*=e.deltaY>0?1.08:0.92; setCam(); });
addEventListener('resize',()=>{ ren.setSize(innerWidth,innerHeight); cam.aspect=innerWidth/innerHeight; cam.updateProjectionMatrix(); });
view('iso'); (function loop(){ requestAnimationFrame(loop); ren.render(scene,cam); })();
</script></body></html>
"""


def html(d):
    tpl = HTML
    if B.VARIANT != "base":       # no buttons on the main board
        tpl = tpl.replace("['S3','S1','S2'].forEach(r=>{ const b=DATA.derived.buttons[r], c=b.centre;",
                          "Object.keys(DATA.derived.buttons).forEach(r=>{ const b=DATA.derived.buttons[r], c=b.centre;")
        tpl = tpl.replace("Przód (góra) = wyświetlacz i przyciski; tył = reszta.", "Przód (góra) = wyświetlacz; przyciski są na osobnej płytce; tył = reszta.")
    return tpl % dict(W=B.P["W"], H=B.P["H"], DATA=json.dumps(d))


def write_all(out):
    if B.K3:
        os.makedirs(out, exist_ok=True)
        open(os.path.join(out, "pcb-layout.json"), "w").write(json.dumps(layout_json_k3(), indent=1))
        return
    d = layout_json()
    os.makedirs(out, exist_ok=True)
    open(os.path.join(out, "pcb-layout.json"), "w").write(json.dumps(d, indent=1))
    open(os.path.join(out, "pcb_params.scad"), "w").write(scad_params(d))
    open(os.path.join(out, "pcb-przekroj.svg"), "w").write(side_svg())
    open(os.path.join(out, "podglad-3d.html"), "w").write(html(d))
