michalstocki/tiny-timer/tools/sim/include/avr/regs_undef.h

#undef DDRB
#undef PORTB
#undef PINB
#undef ADMUX
#undef ADCSRA
#undef ADCH
#undef TCCR0A
#undef TCCR0B
#undef OCR0A
#undef OCR0B
#undef TCNT0
#undef TIMSK0
#undef TIFR0
#undef MCUCR
#undef GIMSK
#undef GIFR
#undef PCMSK
#undef OSCCAL
