michalstocki/tiny-timer/(commit log)

2026-10-17 Minutnik ATtiny13A: firmware, instrukcja montażu, narzędzia weryfikacji
    - firmware/: C (avr-gcc -Os), Makefile, timer (1016 B flash, 6 B RAM),
    programy testowe (ton, OLED, przyciski) i kalibracyjny; wariant plan B
    dla ATtiny25/45/85 z ramką postępu i ikoną dzwonka
    - tools/sim: symulacja logiki firmware na komputerze (54 sprawdzenia)
    - tools/breadboard: układ płytki, weryfikacja sieci ze schematem,
    testy mutacyjne, generator rysunków SVG i instrukcji montażu
    - docs/: instrukcja montażu, programowanie ISP, kalibracja, testy
    odbiorcze, diagnostyka, plan B, schemat, raport końcowy
    - dist/: gotowe pliki .hex i raport avr-size
    Nic nie zostało sprawdzone na sprzęcie.
    Co-Autho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
2026-10-17 Programowanie poza układem: bez przewodów ISP na płytce stykowej
    Użytkownik ma płytkę programatora z gniazdem DIP-8 (UNO z ArduinoISP,
    kondensator 10 µF). ATtiny jest wyjmowany z płytki stykowej na czas
    programowania, więc:
    - design.py: usunięty tryb ISP, C4 i przewody UNO; R2 i przewody OLED
    zostają na stałe; bateria wpinana już w Etapie 1
    - instrukcja montażu, rysunki i weryfikacja przegenerowane (netlista
    zgodna, 14 testów mutacyjnych wykrywa błędy)
    - programowanie.md: procedura wymiany układu, tabela okablowania gniazda
    - diagnostyka, kalibracja, raport i README dostosowane
2026-10-17 Rezystory: R1 15 kΩ, R5 = R6 = 8,2 kΩ (brak 10 kΩ)
    Drabinka PB4 wymaga R5 = R6 (50% VCC przy "−"); R1 nie jest krytyczny.
    Instrukcja, kody kolorów, sprawdzenia i schemat zaktualizowane.
2026-10-19 PCB iteracja 1: wstępne rozmieszczenie, trasowanie i specyfikacja dla obudowy
    Płytka 48 x 50 mm, dwustronna: wyświetlacz i przyciski B3F-4055 na przodzie,
    reszta (przewlekana) z tyłu. Model w tools/pcb: elementy, reguły geometrii,
    optymalizacja rozmieszczenia, router sprawdzający wykonalność, podglądy SVG
    i 3D, specyfikacja mechaniczna dla agenta od obudowy (JSON, SCAD, MD).
    Bez plików produkcyjnych. Sprzeczność karty B3F z pomiarem właściciela
    (które nóżki są zwarte) oznaczona do wyjaśnienia.
    [pcb-layout.json, pcb_params.scad]
2026-10-19 Obudowa iteracja 2: model w Blenderze, podział na czarę i blok, koszyk 3xAAA
    Parametryczny skrypt bpy (tools/enclosure) czyta docs/pcb/pcb-layout.json i buduje
    obudowę 76 x 57 x 33,8 mm: czara przednia z płytką, blok tylny z koszykiem 3xAAA,
    głośnikiem i klapką zatrzaskową, kapsle przycisków, 4 wkręty M2,5, zaokrąglenia
    R3 (front) i R1,5 (tył). Wyjście: .blend, STL, rendery, kontrola kolizji.
    [kapsle.stl, klapka-baterii.stl, obudowa-przod.stl, obudowa-tyl.stl, obudowa.blend]
2026-10-19 Obudowa: front R6, półkoliste okno wyświetlacza, poprawione zaokrąglenia
    Zaokrąglenia budowane warstwami zamiast bmesh bevel, który nie wcinał krawędzi
    (wierzchołki przesuwały się tylko w pionie). Front R6 jak krawędzie pionowe, tył R1,5,
    wnętrze czary współśrodkowe (ścianka 1,6-2,0 mm), słupki przycinane do obrysu.
    Okno OLED z końcami w kształcie półkola (R5,3), gładkie cieniowanie w renderach.
    [obudowa-przod.stl, obudowa-tyl.stl, obudowa.blend]
2026-10-19 Obudowa: wariant klin z osobną płytką przycisków, zdejmowaną pokrywą i koszykiem 3xAAA od spodu
    Skrypt bpy tools/enclosure/build_wedge.py (z bpyutil.py) buduje klin 74,4 x 83,3 x 60,3 mm:
    płytka główna równolegle do skosu 60°, pozioma płytka przycisków pod grzbietem, środkowy
    przycisk w kulistym zagłębieniu 2 mm niżej, głośnik w trójkątnym boku. Pokrywa niesie obie
    płytki i schodzi po czterech wkrętach z boków. Kontrola kolizji: 0 w 147 parach.
    [kapsle.stl, klapka-baterii.stl, korpus.stl, obudowa-klin.blend, pokrywa.stl]
2026-10-19 PCB: wariant klin (48 x 36 mm, bez przycisków) równolegle do podstawowego; klin przebudowany na nowej płytce
    tools/pcb: flaga --variant klin (board.py, layout_klin.py, optimize/export/render/spec) generuje
    docs/pcb-klin/: płytka główna bez S1-S3, pola KEY na 4 przewody do osobnej płytki przycisków,
    rozmieszczenie z optimize.py (ziarno 4), trasowanie bez błędów. Wariant podstawowy bez zmian
    (wszystkie pliki generowane w docs/pcb są bajt w bajt takie same).
    Klin: model z docs/pcb-klin, 74,4 x 75,4 x 46,0 mm (było 83,3 x 60,3 na płytce 48 x 50), koszyk
    odejmowany od wnętrza zamiast dokładany do powłoki (zdegenerowane krawędzie), kolizje 0/147.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
    [kapsle.stl, klapka-baterii.stl, korpus.stl, obudowa-klin.blend, pcb-layout.json, pcb_params.scad, pokrywa.stl]
2026-10-19 Obudowa klin: bok jako zaokrąglony trójkąt równoboczny, przyciski na wierzchołku (tabletka w obniżeniu)
    Przekrój zmieniony z trapezu na trójkąt równoboczny (bok 80 mm, R13 przy wierzchołku, R5 przy podstawie),
    zaokrąglone krawędzie boków R3. Kapsle "-" i "+" mają powierzchnię zlicowaną z łukiem wierzchołka,
    środkowy to wypukła tabletka w wydłużonym obniżeniu. Pokrywa obejmuje wierzchołek i schodzi pionowo.
    Płytka przycisków 52 x 16 mm (rozstaw 18 mm), dane w docs/pcb-klin zaktualizowane; płytka bazowa bez zmian.
    Wymiary 77,4 x 72,7 x 56,3 mm, kolizje 0/147.
    [kapsle.stl, klapka-baterii.stl, korpus.stl, obudowa-klin.blend, pcb-layout.json, pokrywa.stl]
2026-10-19 Obudowa klin 2: ogniwa w układzie trójkąta 2 + 1, wkładane od prawego boku
    Skrypt build_wedge.py dostał przełącznik TT_BATTERY=row|triangle (domyślnie row, wariant 1 bez zmian).
    Układ trójkątny: bok 77,5 mm (rząd 80 mm, płasko na tylnej ściance 80 mm bez zysku, dolna granica bez baterii
    77,5 mm), 77,4 x 70,2 x 54,1 mm, pokrywka baterii w prawym boku w kształcie zaokrąglonego trójkąta.
    Kolizje 0/147. README opisuje, że o rozmiarze decyduje płytka przycisków przy wierzchołku, nie ogniwa.
    [kapsle.stl, korpus.stl, obudowa-klin.blend, pokrywa.stl, pokrywka-baterii.stl]
2026-10-19 Obudowa klin 3: wyświetlacz osobno na froncie, płytka 40x24 na tylnej ściance pokrywy, ogniwa 2+1 od góry, zatrzask zamiast wkrętów
    Bok trójkąta 72,0 mm (było 77,5), bryła 69,4 x 67,0 x 49,4 mm. Nowy wariant PCB klin3 (bez OLED i przycisków),
    solver przekroju wedge3_solver.py, kontrole kolizji, zdejmowania pokrywy i wkładania ogniw. Warianty base, klin,
    klin 1 i klin 2 bez zmian.
    [kapsle.stl, korpus.stl, obudowa-klin-3.blend, pcb-layout.json, pokrywa.stl]
2026-10-19 Obudowa klin 3.1: wtyczki poza zasięgiem ogniw, szew frontu na narożniku z zakładkami i języczkami, zatrzask z języka w U-szczelinie
    Bok 71,0 mm, 73,0 x 63,7 x 48,5 mm. Naprawiony błąd klina 3 (język zatrzasku wystawał poza prosty odcinek tyłu).
    Kontrola kolizji liczona w obu kolejnościach, kontrola zdejmowania pokrywy i wkładania ogniw bez kolizji.
    [kapsle.stl, korpus.stl, obudowa-klin-3.1-concept.blend, obudowa-klin-3.1.blend, pokrywa.stl]
2026-10-19 Obudowa klin 4: szew tyłu na narożniku, 4 zatrzaski przy podstawie, gniazda styków Keystone, kapsle wciskane na B3F-4055
    - przekrój: bok 67,5 mm, wysokość 45,5 mm (klin 3.1: 71,0 / 48,5), obudowa 74,2 x 60,2 x 45,5 mm
    - ogniwa w rzędzie co 11,5 mm (styki 5204, 5226, 5213/5214 wg katalogu Keystone M65, odległość płytek 49,5 mm)
    - wyświetlacz bez wtyczek, okno i przyciski na środku długości
    - zatrzaski: nogi z zaczepem pod półkami korpusu, zwalniane spinaczem przez otwory w spodzie; kontrola blokady
    (w górę, w przód, w tył, podważenie przodu i tyłu: wszystko zablokowane)
    - płytka przycisków: rozstaw 17,78 mm (raster 2,54) i otwory M2 na oczkach, pod płytkę uniwersa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
    [kapsle.stl, korpus.stl, obudowa-klin-4-bez-zaczepow.blend, obudowa-klin-4.blend, pcb-layout.json, pokrywa.stl]
2026-10-22 Płytka przycisków na płytce uniwersalnej: szablon 1:1, schemat, instrukcja montażu
    Szablon PDF (zarys 50x16, otwory M2, siatka oczek), połączenia od strony lutowania,
    schemat elektryczny i kontrola multimetrem wg karty Omron B3F-4055 (4-3 i 2-1 połączone
    na stałe, nóżki 12,5 mm). Generator tools/pcb/button_board.py sprawdza logikę sieci dla
    wszystkich kombinacji wciśnięć oraz odległości od łbów wkrętów M2.
2026-10-22 Płytka główna: trasowanie 2 warstw, DRC/LVS, plik KiCada i podglądy
    Router o siatce 0,1 mm (45°, przelotki) przy niezmienionych położeniach elementów z klina 3;
    jedyna zmiana stopki to rozstaw C3 (Ø5, 2,0 mm) i pola przewodów Ø2,0. Niezależny DRC i porównanie
    z netlistą na dokładnej geometrii (0 błędów, najmniejszy odstęp 0,28 mm), eksport tt-main.kicad_pcb
    (format v7) oraz podglądy SVG obu stron. Eksport Gerberów: do wykonania kicad-cli (osobny krok).
    [tt-main.kicad_pcb]
2026-10-22 Płytka główna: instrukcja montażu z kontrolami, BOM, plany, skrypt eksportu i przekazanie
    Instrukcja montażu (etapy 0-9 z krokami kontrolnymi: ciągłość gołej płytki, rezystancje po
    rezystorach, test diod i tranzystora, pierwsze zasilanie bez układu), plan montażu i plan
    pomiarów, BOM, README z parametrami zamówienia, export_fab.sh (DRC + Gerbery przez kicad-cli)
    oraz PRZEKAZANIE.md dla sesji na komputerze z KiCadem. Gerbery jeszcze nie wyeksportowane.
    [bom.csv, tt-main.kicad_pcb]
2026-10-22 BOM: końce linii LF
2026-10-22 Płytka główna: eksport Gerberów w KiCadzie 10, DRC KiCada, poprawka opisu przy narożniku
    - export_fab.sh uruchomiony na KiCadzie 10.0.7: DRC bez błędów, Gerbery, wiercenia PTH/NPTH, zip dla fabryki
    - fab_silk.py: szerokość znaku zmierzona w Gerberze (0,85 zamiast 0,62) i kontrola łuków narożników;
    napis TT-MAIN v1.0 wychodził poza płytkę
    - export_fab.sh: tryb --mode-single dla SVG w KiCadzie 9+, mapy wierceń poza zipem
    - README: status i wyniki kontroli
    [tt-main-B_Cu.gbl, tt-main-B_Mask.gbs, tt-main-B_Silkscreen.gbo, tt-main-Edge_Cuts.gm1, tt-main-F_Cu.gtl, tt-main-F_Mask.gts, tt-main-F_Silkscreen.gto, tt-main-NPTH-drl_map.gbr]
2026-10-22 Płytka główna: napisy TOP/BOT w miedzi na prośbę fabryki
    - fab_cutext.py: „TOP” na F.Cu i lustrzany „BOT” na B.Cu (1,2 mm, kreska 0,25 mm, bez sieci),
    w miejscu z największym odstępem od miedzi, poza opisami i strefami otworów M2,5
    - fab_kicad.py, fab_build.py, fab_render.py: zapis napisów do pliku KiCada i podglądów
    - produkcja/: nowy eksport (DRC KiCada bez błędów), nowy zip dla fabryki
    [tt-main-B_Cu.gbl, tt-main-B_Mask.gbs, tt-main-B_Silkscreen.gbo, tt-main-Edge_Cuts.gm1, tt-main-F_Cu.gtl, tt-main-F_Mask.gts, tt-main-F_Silkscreen.gto, tt-main-NPTH-drl_map.gbr]
2026-10-22 Remove unused files from previous iterations
    [kapsle.stl, klapka-baterii.stl, korpus.stl, obudowa-klin-3.1-concept.blend, obudowa-klin-3.1.blend, obudowa-klin-3.blend, obudowa-klin.blend, obudowa-przod.stl]
